jfhansen/3-Phased-Inverter-for-Electric-Gokart/ThreePhaseInverter_Angled.jpg

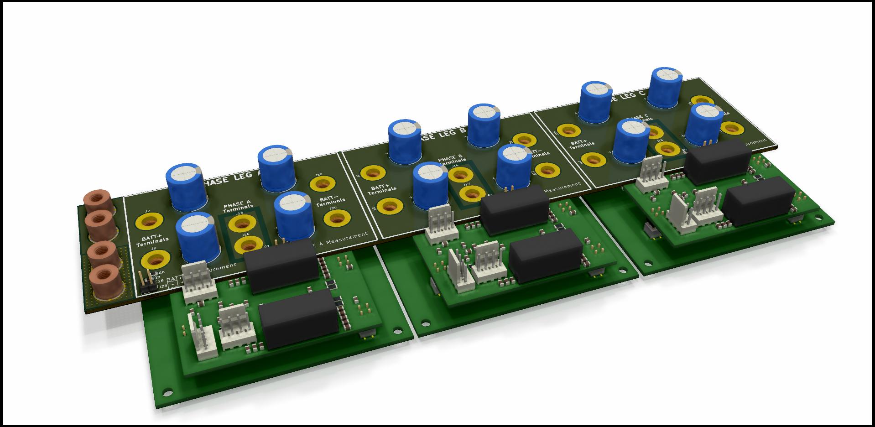
ThreePhaseInverter_Angled.jpg
