jfhansen/3-Phased-Inverter-for-Electric-Gokart/ThreePhaseInverter.jpg

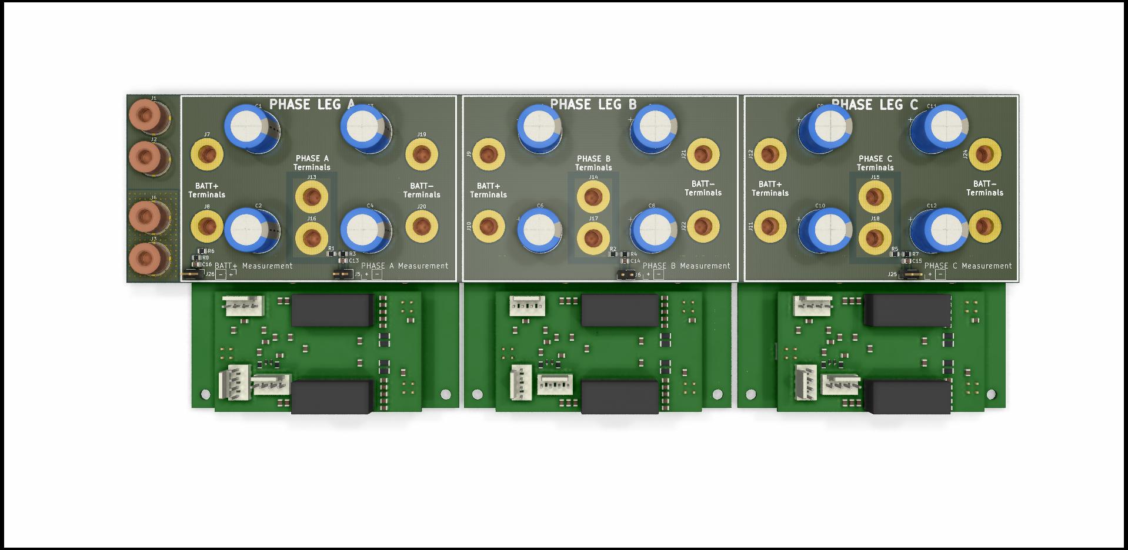
ThreePhaseInverter.jpg
