jfhansen/3-Phased-Inverter-for-Electric-Gokart/README.md

# 3-Phased-Inverter-for-Electric-Gokart
Repository containing Simulation files, PCB files and embedded software for three-phased inverter drive.
