jfhansen/3-Phased-Inverter-for-Electric-Gokart/GateDriverPCB/GateDriver/GateDriver.jpg

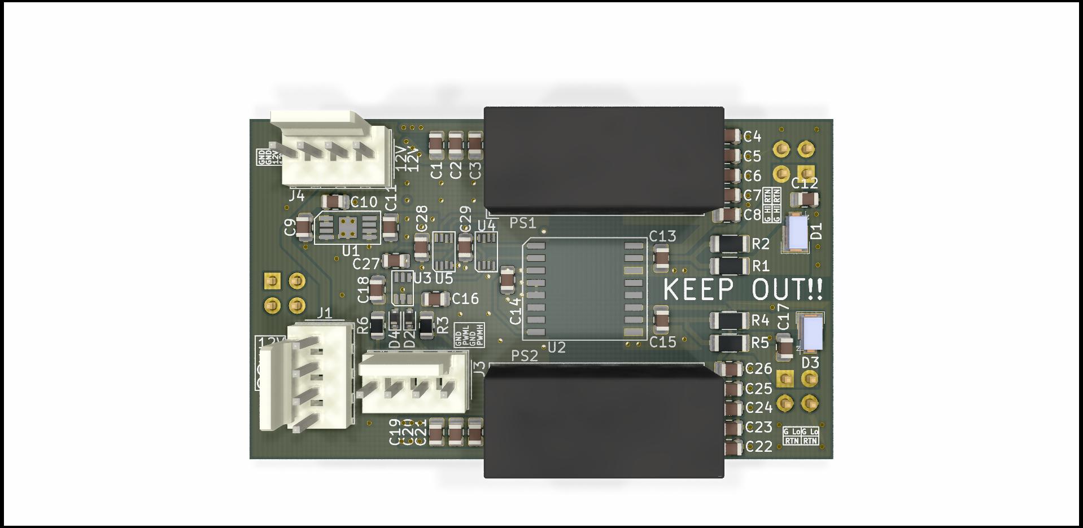
GateDriverPCB/GateDriver/GateDriver.jpg
