jfhansen/3-Phased-Inverter-for-Electric-Gokart/GateDriverPCB/GateDriver/GateDriverAngled.jpg

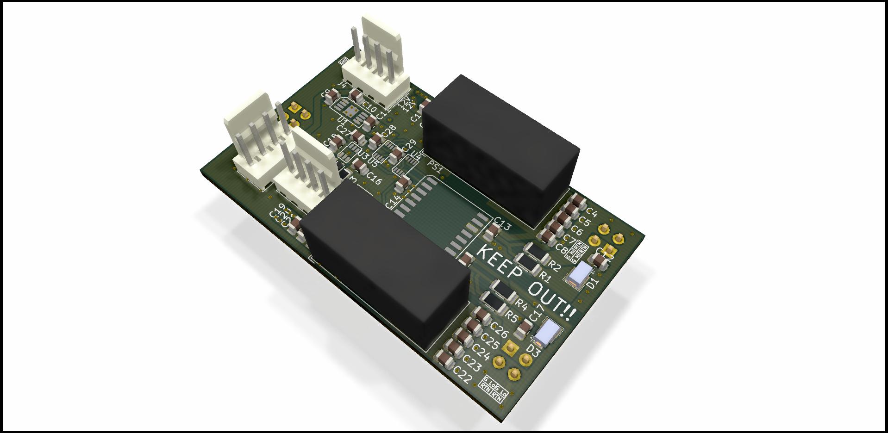
GateDriverPCB/GateDriver/GateDriverAngled.jpg
