jfhansen/3-Phased-Inverter-for-Electric-Gokart/InverterPCB/ThreePhaseInverter/ThreePhaseInverter.jpg

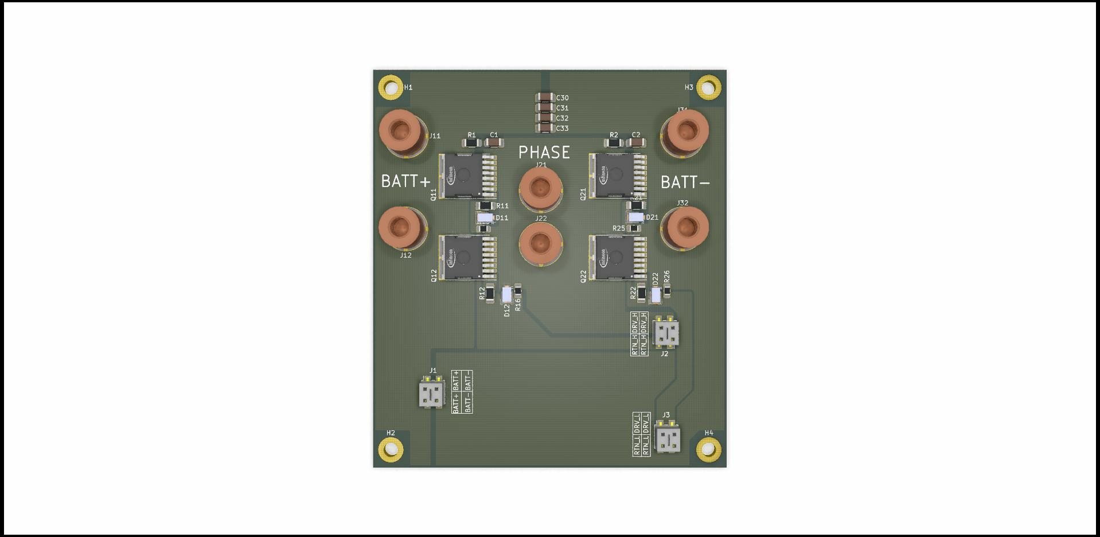
InverterPCB/ThreePhaseInverter/ThreePhaseInverter.jpg
