jfhansen/3-Phased-Inverter-for-Electric-Gokart/InverterPCB/ThreePhaseInverter/ThreePhaseInverter_wGateDriver.jpg

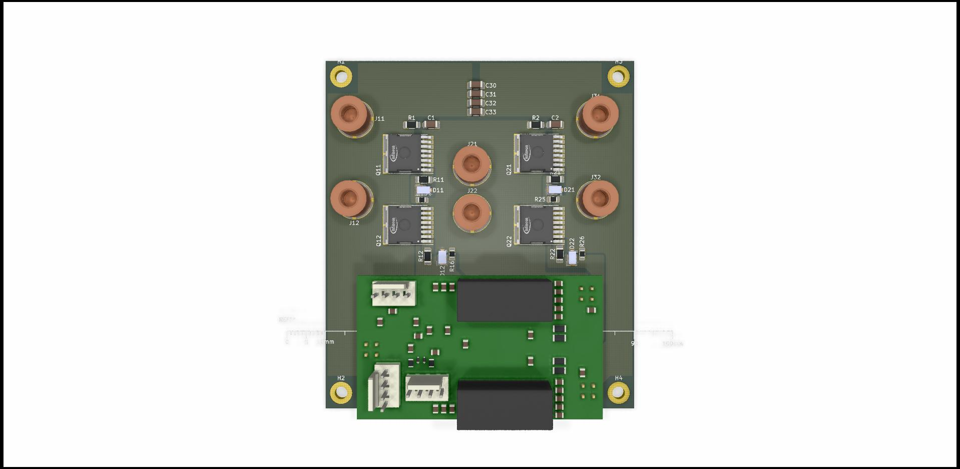
InverterPCB/ThreePhaseInverter/ThreePhaseInverter_wGateDriver.jpg
