jfhansen/3-Phased-Inverter-for-Electric-Gokart/InverterPCB/ThreePhaseInverter/ThreePhaseInverterAngled.jpg

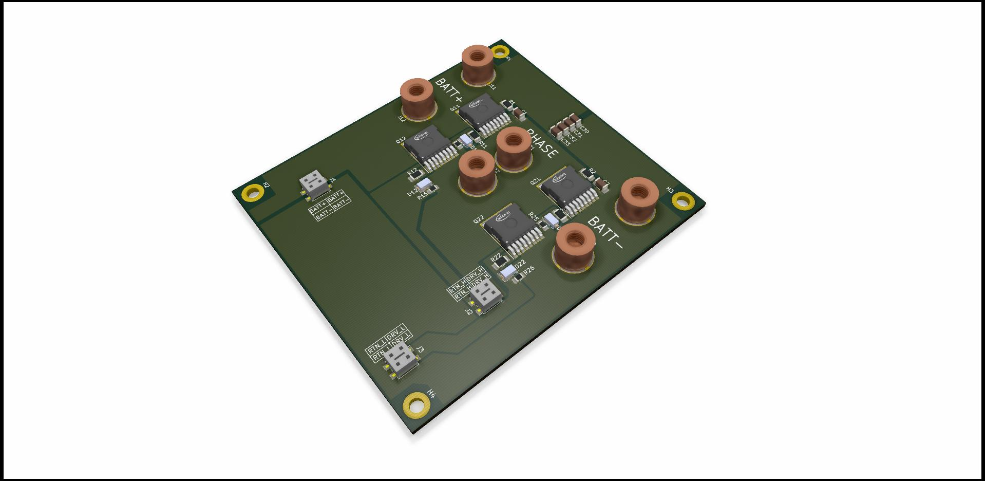
InverterPCB/ThreePhaseInverter/ThreePhaseInverterAngled.jpg
