jfhansen/3-Phased-Inverter-for-Electric-Gokart/DCLinkPCB/DCLink/DCLink.step

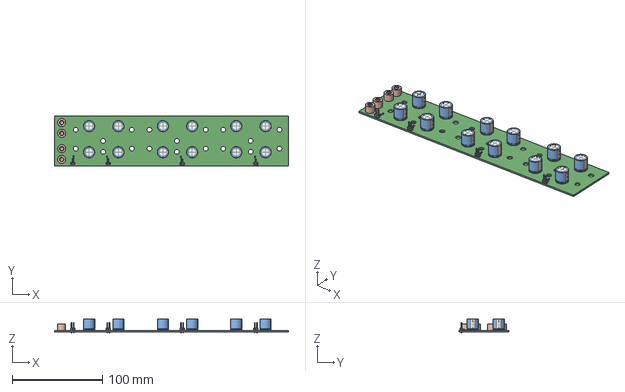
[picture p8: CAD file, 2021-04-16]
DCLinkPCB/DCLink/DCLink.step
260.0 x 55.0 x 15.5 mm
