jfhansen/3-Phased-Inverter-for-Electric-Gokart/GateDriverPCB/GateDriver/GateDriver.step

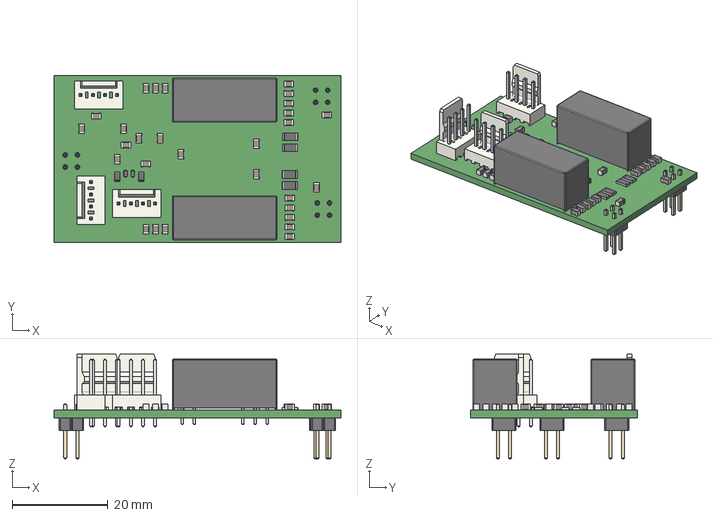
[picture p9: CAD file, 2021-04-16]
GateDriverPCB/GateDriver/GateDriver.step
60.0 x 35.0 x 21.9 mm
