jfhansen/3-Phased-Inverter-for-Electric-Gokart/GateDriverPCB/GateDriver/GateDriver.kicad_pcb

## KiCad design GateDriverPCB/GateDriver/GateDriver.kicad_pcb (2021-04-16)

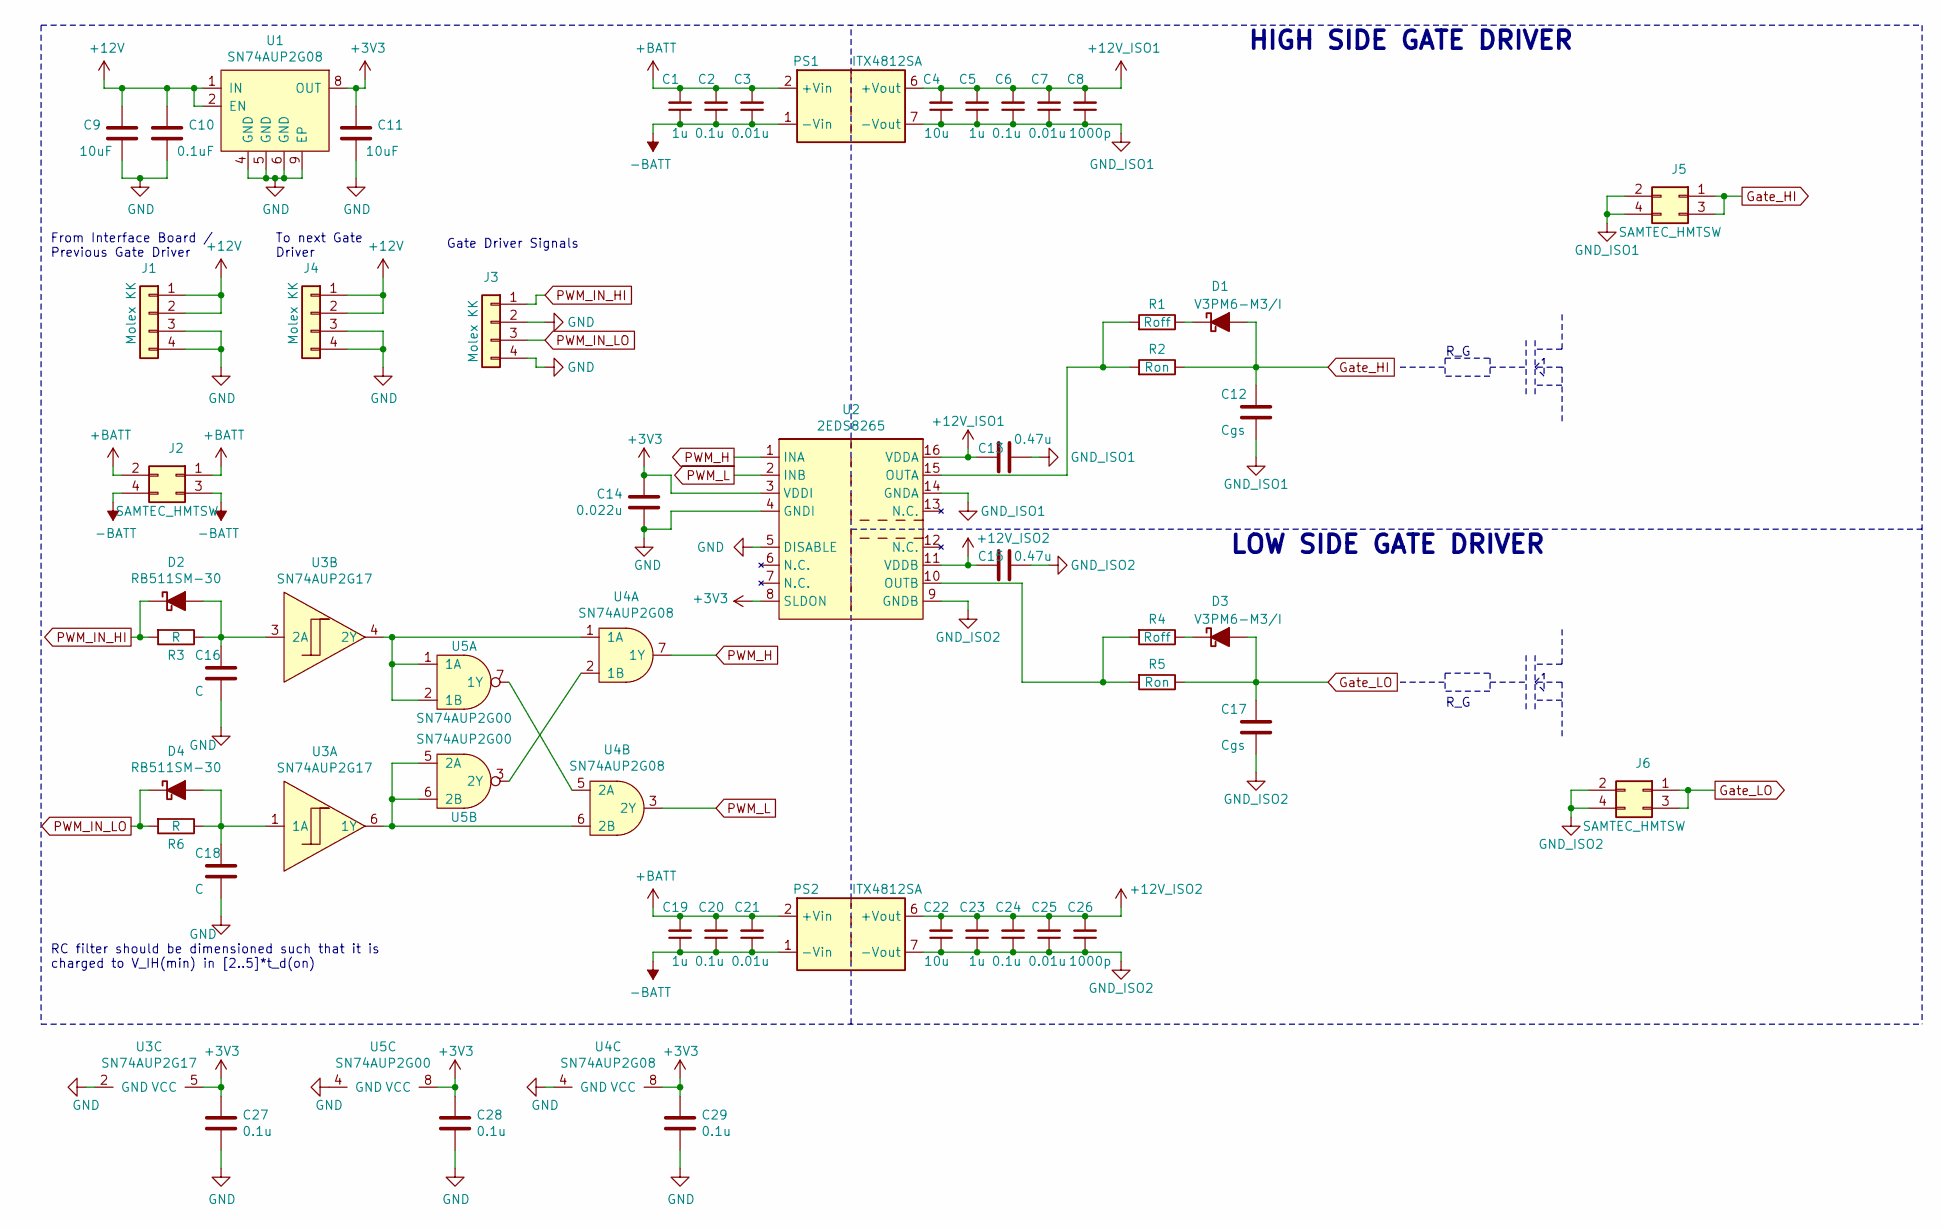
[picture p10: schematic GateDriver.sch]

Parts:
C1, C5, C19, C23: 1u; C_0805_2012Metric
C2, C6, C20, C24, C27, C28, C29: 0.1u; C_0805_2012Metric
C3, C7, C21, C25: 0.01u; C_0805_2012Metric
C4, C22: 10u; C_0805_2012Metric
C8, C26: 1000p; C_0805_2012Metric
C9, C11: 10uF; C_0805_2012Metric
C10: 0.1uF; C_0805_2012Metric
C12, C17: Cgs; C_0805_2012Metric
C13, C15: 0.47u; C_0805_2012Metric
C14: 0.022u; C_0805_2012Metric
C16, C18: C; C_0805_2012Metric
D1, D3: V3PM6-M3/I; D_SMP_DO-220AA
D2, D4: RB511SM-30; D_SOD-523
J1, J3, J4: Molex KK; Molex_KK-254_AE-6410-04A_1x04_P2.54mm_Vertical
J2, J5, J6: SAMTEC_HMTSW; PinHeader_2x02_P2.54mm_Vertical; Part No. HMTSW-102-22-L-D-370
PS1, PS2: ITX4812SA; Converter_DCDC_XP_POWER-ITXxxxxSA_THT
R1, R4: Roff; R_1206_3216Metric
R2, R5: Ron; R_1206_3216Metric
R3, R6: R; R_0805_2012Metric
U1: SN74AUP2G08; TI-VSSOP-8-PowerPAD
U2: 2EDS8265; PG-DSO-16-30
U3: SN74AUP2G17; DCK_R-PDSO-G6
U4: SN74AUP2G08; R-PDSO-G8
U5: SN74AUP2G00; R-PDSO-G8

Connections:
+3V3: C11.2, C14.1, C27.1, C28.1, C29.1, U1.8 (OUT), U2.3 (VDDI), U2.8 (SLDON), U3.5 (VCC), U4.8 (VCC), U5.8 (VCC)
+12V: C9.2, C10.2, J1.1, J1.2, J4.1, J4.2, U1.1 (IN), U1.2 (EN)
+12V_ISO1: C4.2, C5.2, C6.2, C7.2, C8.2, C13.2, PS1.6 (+Vout), U2.16 (VDDA)
+12V_ISO2: C15.2, C22.2, C23.2, C24.2, C25.2, C26.2, PS2.6 (+Vout), U2.11 (VDDB)
+BATT: C1.2, C2.2, C3.2, C19.2, C20.2, C21.2, J2.1, J2.2, PS1.2 (+Vin), PS2.2 (+Vin)
-BATT: C1.1, C2.1, C3.1, C19.1, C20.1, C21.1, J2.3, J2.4, PS1.1 (-Vin), PS2.1 (-Vin)
GND: C9.1, C10.1, C11.1, C14.2, C16.2, C18.2, C27.2, C28.2, C29.2, J1.3, J1.4, J3.2, J3.4, J4.3, J4.4, U1.4 (GND), U1.5 (GND), U1.6 (GND), U1.9 (EP), U2.4 (GNDI), U2.5 (DISABLE), U3.2 (GND), U4.4 (GND), U5.4 (GND)
GND_ISO1: C4.1, C5.1, C6.1, C7.1, C8.1, C12.2, C13.1, J5.2, J5.4, PS1.7 (-Vout), U2.14 (GNDA)
GND_ISO2: C15.1, C17.2, C22.1, C23.1, C24.1, C25.1, C26.1, J6.2, J6.4, PS2.7 (-Vout), U2.9 (GNDB)
Gate_HI: C12.1, D1.2 (A), J5.1, J5.3, R2.1
Gate_LO: C17.1, D3.2 (A), J6.1, J6.3, R5.1
unnamed: C16.1, D2.2 (A), R3.1, U3.3 (2A)
unnamed: C18.1, D4.2 (A), R6.1, U3.1 (1A)
unnamed: D1.1 (K), R1.1
unnamed: D3.1 (K), R4.1
unnamed: R1.2, R2.2, U2.15 (OUTA)
unnamed: R4.2, R5.2, U2.10 (OUTB)
unnamed: U3.4 (2Y), U4.1 (1A), U5.1 (1A), U5.2 (1B)
unnamed: U3.6 (1Y), U4.6 (2B), U5.5 (2A), U5.6 (2B)
unnamed: U4.2 (1B), U5.3 (2Y)
unnamed: U4.5 (2A), U5.7 (1Y)
PWM_H: U2.1 (INA), U4.7 (1Y)
PWM_IN_HI: D2.1 (K), J3.1, R3.2
PWM_IN_LO: D4.1 (K), J3.3, R6.2
PWM_L: U2.2 (INB), U4.3 (2Y)

Notes on the sheet:
HIGH SIDE GATE DRIVER
LOW SIDE GATE DRIVER
RC filter should be dimensioned such that it is charged to V_IH(min) in [2..5]*t_d(on)
R_G
From Interface Board / Previous Gate Driver
To next Gate Driver
Gate Driver Signals

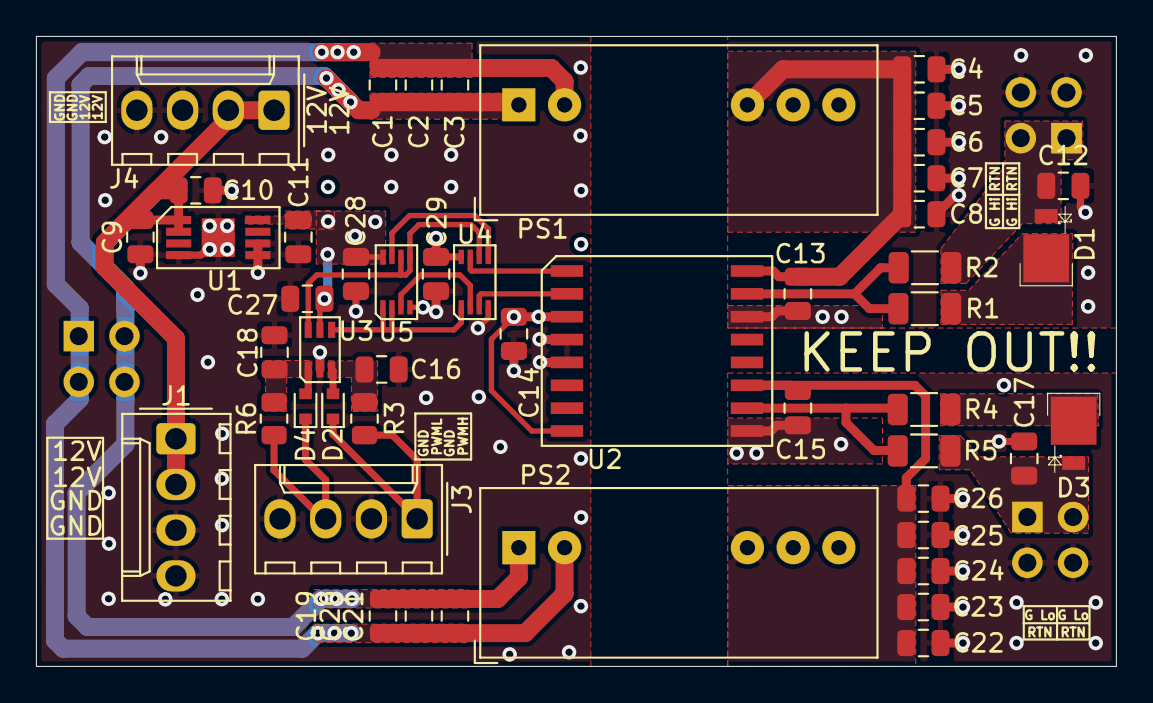
[picture p11: board GateDriver.kicad_pcb from above]

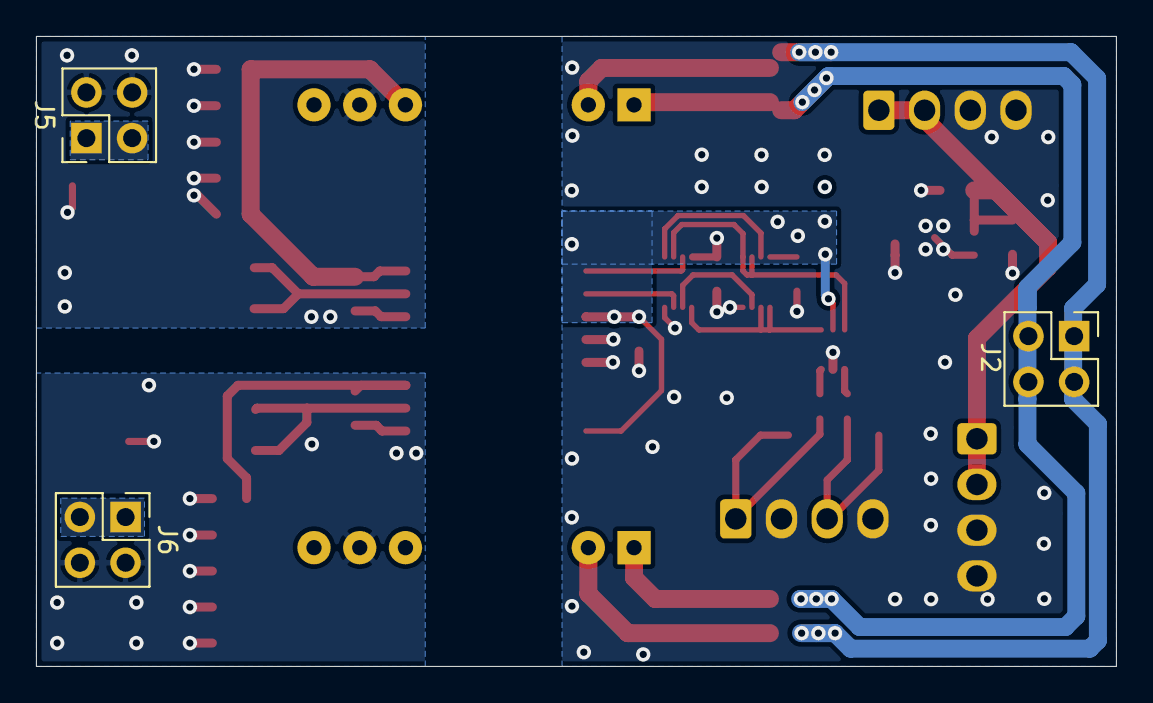
[picture p12: board GateDriver.kicad_pcb from below]

Board: 2 copper layers, 60.0 x 35.0 mm, 52 parts (3 on the bottom side), 25 nets.
