jfhansen/3-Phased-Inverter-for-Electric-Gokart/InverterPCB/ThreePhaseInverter/ThreePhaseInverter.kicad_pcb

## KiCad design InverterPCB/ThreePhaseInverter/ThreePhaseInverter.kicad_pcb (2021-04-16)

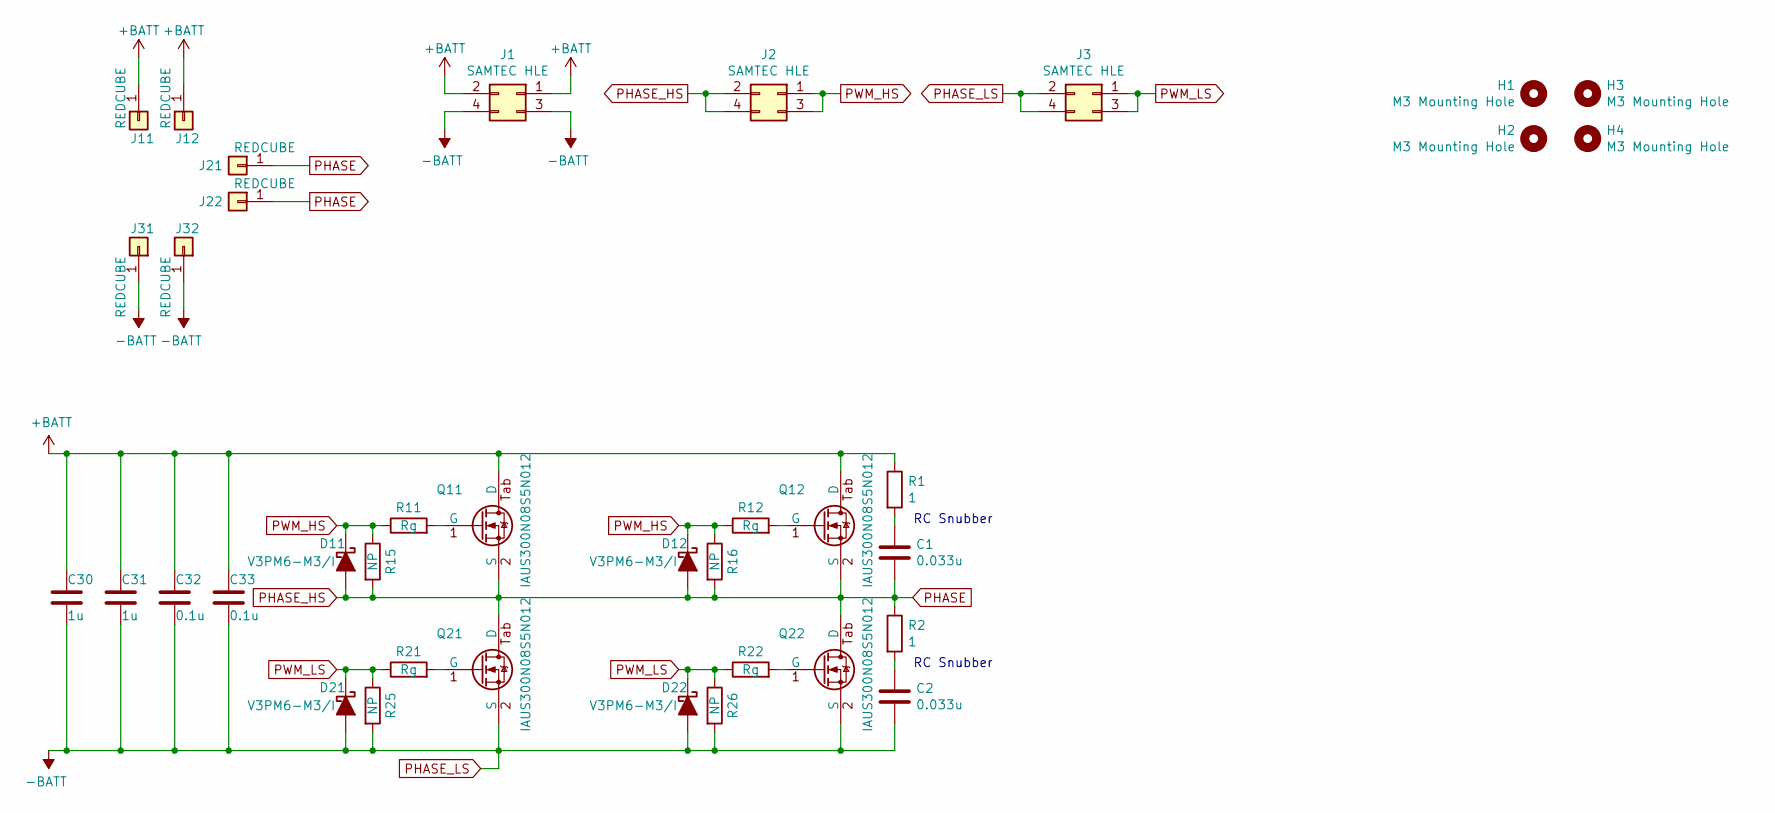
[picture p13: schematic ThreePhaseInverter.sch]

Parts:
C1, C2: 0.033u; C_1206_3216Metric_Pad1.33x1.80mm_HandSolder
C30, C31: 1u; C_1206_3216Metric_Pad1.33x1.80mm_HandSolder
C32, C33: 0.1u; C_1206_3216Metric_Pad1.33x1.80mm_HandSolder
D11, D12, D21, D22: V3PM6-M3/I; D_SMP_DO-220AA
H1, H2, H3, H4: M3 Mounting Hole; MountingHole_3.2mm_M3_ISO7380_Pad
J1, J2, J3: SAMTEC HLE; Samtec_HLE-102-02-xxx-DV_2x02_P2.54mm_Horizontal
J11, J12, J21, J22, J31, J32: REDCUBE; Würth_7466205
Q11, Q12, Q21, Q22: IAUS300N08S5N012; Infineon_PG-HSOG-8-1
R1, R2: 1; R_1206_3216Metric_Pad1.30x1.75mm_HandSolder
R11, R12, R21, R22: Rg; R_1206_3216Metric_Pad1.30x1.75mm_HandSolder
R15, R16, R25, R26: NP; R_0805_2012Metric_Pad1.20x1.40mm_HandSolder

Connections:
+BATT: C30.1, C31.1, C32.1, C33.1, J1.1, J1.2, J11.1, J12.1, Q11.Tab (D), Q12.Tab (D), R1.1
unnamed: C1.1, R1.2
unnamed: C2.1, R2.2
unnamed: Q11.1 (G), R11.2
unnamed: Q12.1 (G), R12.2
unnamed: Q21.1 (G), R21.2
unnamed: Q22.1 (G), R22.2
PHASE: C1.2, D11.2 (A), D12.2 (A), J2.2, J2.4, J21.1, J22.1, Q11.2 (S), Q11.3 (S), Q11.4 (S), Q11.5 (S), Q11.6 (S), Q11.7 (S), Q11.8 (S), Q12.2 (S), Q12.3 (S), Q12.4 (S), Q12.5 (S), Q12.6 (S), Q12.7 (S), Q12.8 (S), Q21.Tab (D), Q22.Tab (D), R2.1, R15.2, R16.2
PHASE_LS: C2.2, C30.2, C31.2, C32.2, C33.2, D21.2 (A), D22.2 (A), J1.3, J1.4, J3.2, J3.4, J31.1, J32.1, Q21.2 (S), Q21.3 (S), Q21.4 (S), Q21.5 (S), Q21.6 (S), Q21.7 (S), Q21.8 (S), Q22.2 (S), Q22.3 (S), Q22.4 (S), Q22.5 (S), Q22.6 (S), Q22.7 (S), Q22.8 (S), R25.2, R26.2
PWM_HS: D11.1 (K), D12.1 (K), J2.1, J2.3, R11.1, R12.1, R15.1, R16.1
PWM_LS: D21.1 (K), D22.1 (K), J3.1, J3.3, R21.1, R22.1, R25.1, R26.1

Notes on the sheet:
RC Snubber

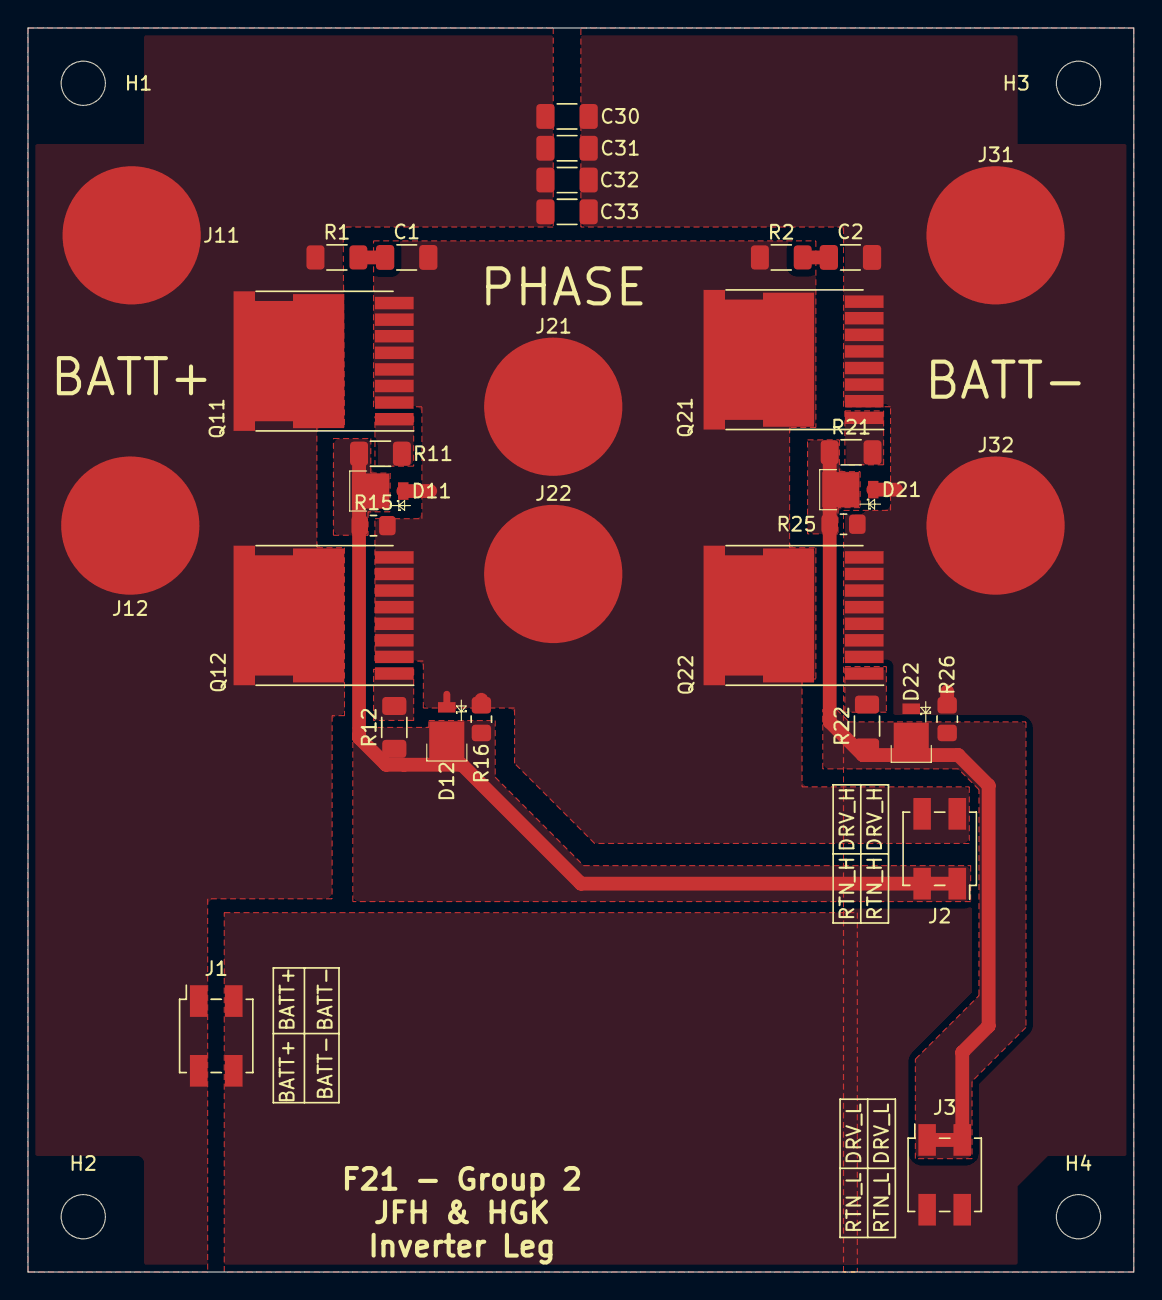
[picture p14: board ThreePhaseInverter.kicad_pcb from above]

Board: 2 copper layers, 80.0 x 90.0 mm, 37 parts (0 on the bottom side), 11 nets.
