jfhansen/3-Phased-Inverter-for-Electric-Gokart/DCLinkPCB/DCLink/DCLink.kicad_pcb

## KiCad design DCLinkPCB/DCLink/DCLink.kicad_pcb (2021-04-16)

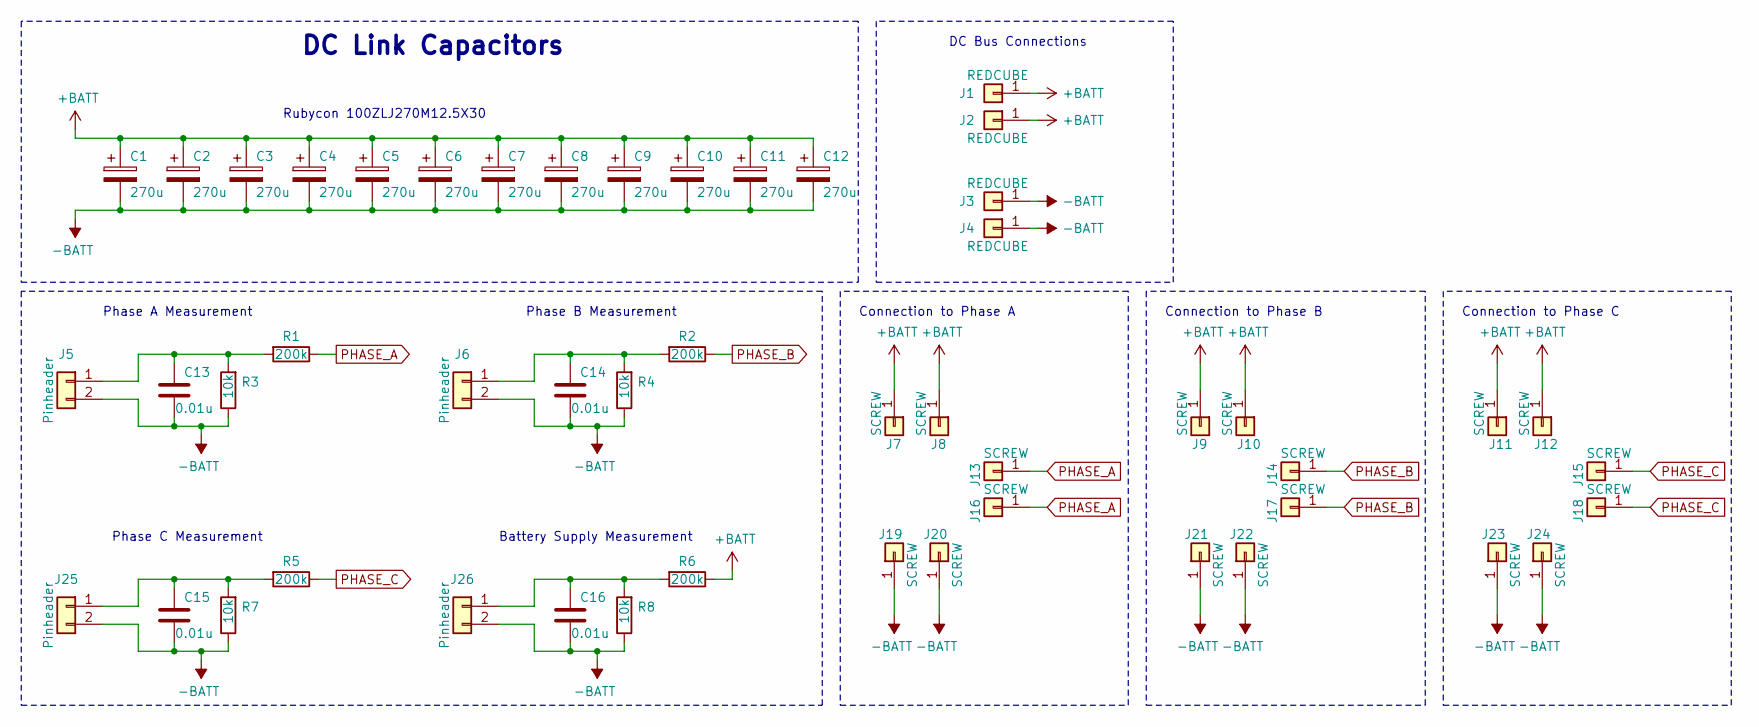
[picture p15: schematic DCLink.sch]

Parts:
C1, C2, C3, C4, C5, C6, C7, C8, C9, C10, C11, C12: 270u; CP_Radial_D12.5mm_P5.00mm; Man. Part No. 100ZLJ270M12.5X30
C13, C14, C15, C16: 0.01u; C_0805_2012Metric
J1, J2, J3, J4: REDCUBE; Würth_7466205
J5, J6, J25, J26: Pinheader; PinHeader_1x02_P2.54mm_Vertical
J7, J8, J9, J10, J11, J12, J13, J14, J15, J16, J17, J18, J19, J20, J21, J22, J23, J24: SCREW; MountingHole_5.3mm_M5_ISO7380_Pad
R1, R2, R5, R6: 200k; R_0805_2012Metric
R3, R4, R7, R8: 10k; R_0805_2012Metric

Connections:
+BATT: C1.1, C2.1, C3.1, C4.1, C5.1, C6.1, C7.1, C8.1, C9.1, C10.1, C11.1, C12.1, J1.1, J2.1, J7.1, J8.1, J9.1, J10.1, J11.1, J12.1, R6.1
-BATT: C1.2, C2.2, C3.2, C4.2, C5.2, C6.2, C7.2, C8.2, C9.2, C10.2, C11.2, C12.2, C13.2, C14.2, C15.2, C16.2, J3.1, J4.1, J5.2, J6.2, J19.1, J20.1, J21.1, J22.1, J23.1, J24.1, J25.2, J26.2, R3.1, R4.1, R7.1, R8.1
unnamed: C13.1, J5.1, R1.2, R3.2
unnamed: C14.1, J6.1, R2.2, R4.2
unnamed: C15.1, J25.1, R5.2, R7.2
unnamed: C16.1, J26.1, R6.2, R8.2
PHASE_A: J13.1, J16.1, R1.1
PHASE_B: J14.1, J17.1, R2.1
PHASE_C: J15.1, J18.1, R5.1

Notes on the sheet:
DC Link Capacitors
Rubycon 100ZLJ270M12.5X30
Phase A Measurement
Phase B Measurement
Phase C Measurement
Battery Supply Measurement
Connection to Phase A
Connection to Phase B
Connection to Phase C
DC Bus Connections

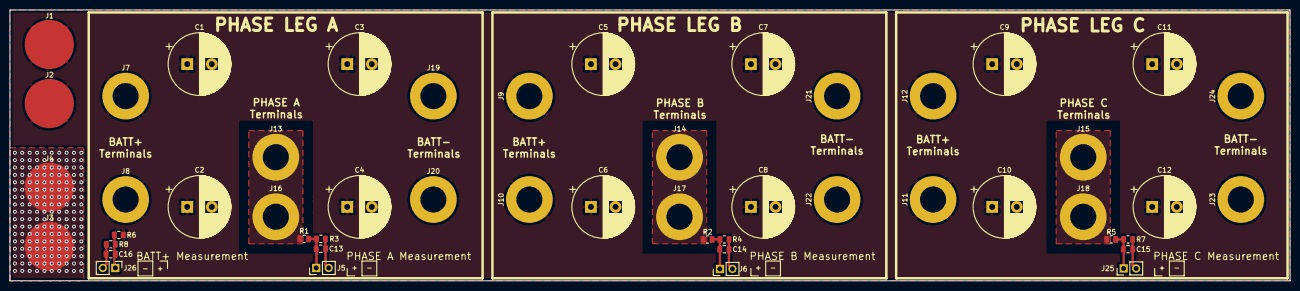
[picture p16: board DCLink.kicad_pcb from above]

Board: 2 copper layers, 260.0 x 55.0 mm, 50 parts (0 on the bottom side), 9 nets.
