jfhansen/3-Phased-Inverter-for-Electric-Gokart/(commit log)

2021-04-02 Started work on schematic for gate driver PCB. Added schematic symbols and footprints in Library folder.
    [GateDriver.kicad_pcb, GateDriver.sch]
2021-04-12 Finished Gate Driver Schematic. Only connectors for connection to Inverter PCB need to be placed.
    [GateDriver.sch]
2021-04-16 Finished PCB layout for Gate Driver, Inverter Leg and DC Link PCB.
    [DCLink-B_Cu.gbl, DCLink-B_Mask.gbs, DCLink-B_Paste.gbp, DCLink-B_SilkS.gbo, DCLink-Edge_Cuts.gm1, DCLink-F_Cu.gtl, DCLink-F_Mask.gts, DCLink-F_Paste.gtp]
